oliwer11/growatt-heater-en-rs485/docs/Relay_5V_2-channel.png

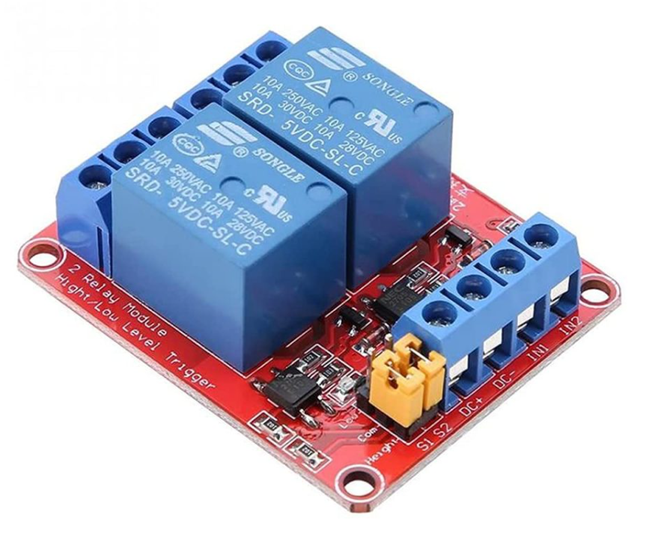
docs/Relay_5V_2-channel.png
