oliwer11/growatt-heater-en-rs485/docs/UART_TTL_RS485_MAX485_5V_ARDUINO.png

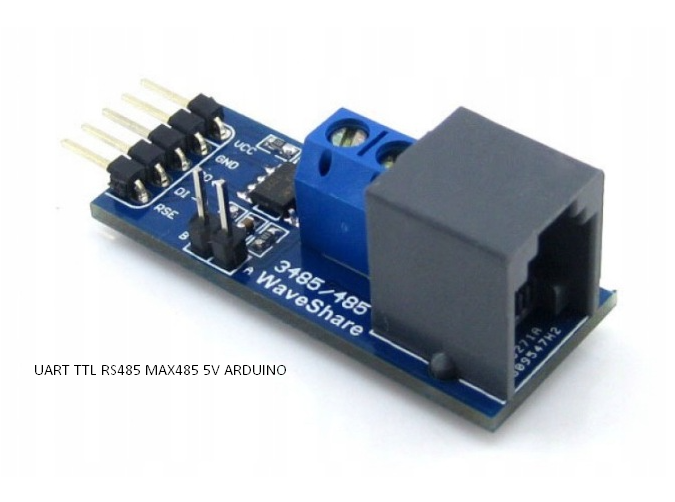
docs/UART_TTL_RS485_MAX485_5V_ARDUINO.png
