oliwer11/growatt-heater-en-rs485/docs/RS485_top_view.png

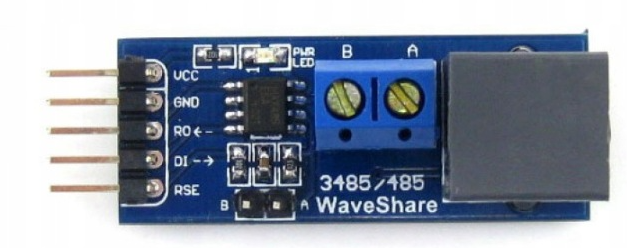
docs/RS485_top_view.png
