oliwer11/growatt-heater-en-rs485/docs/Growatt-heater-wiring-diagram.pdf

/ -L1_1

/ -N_1

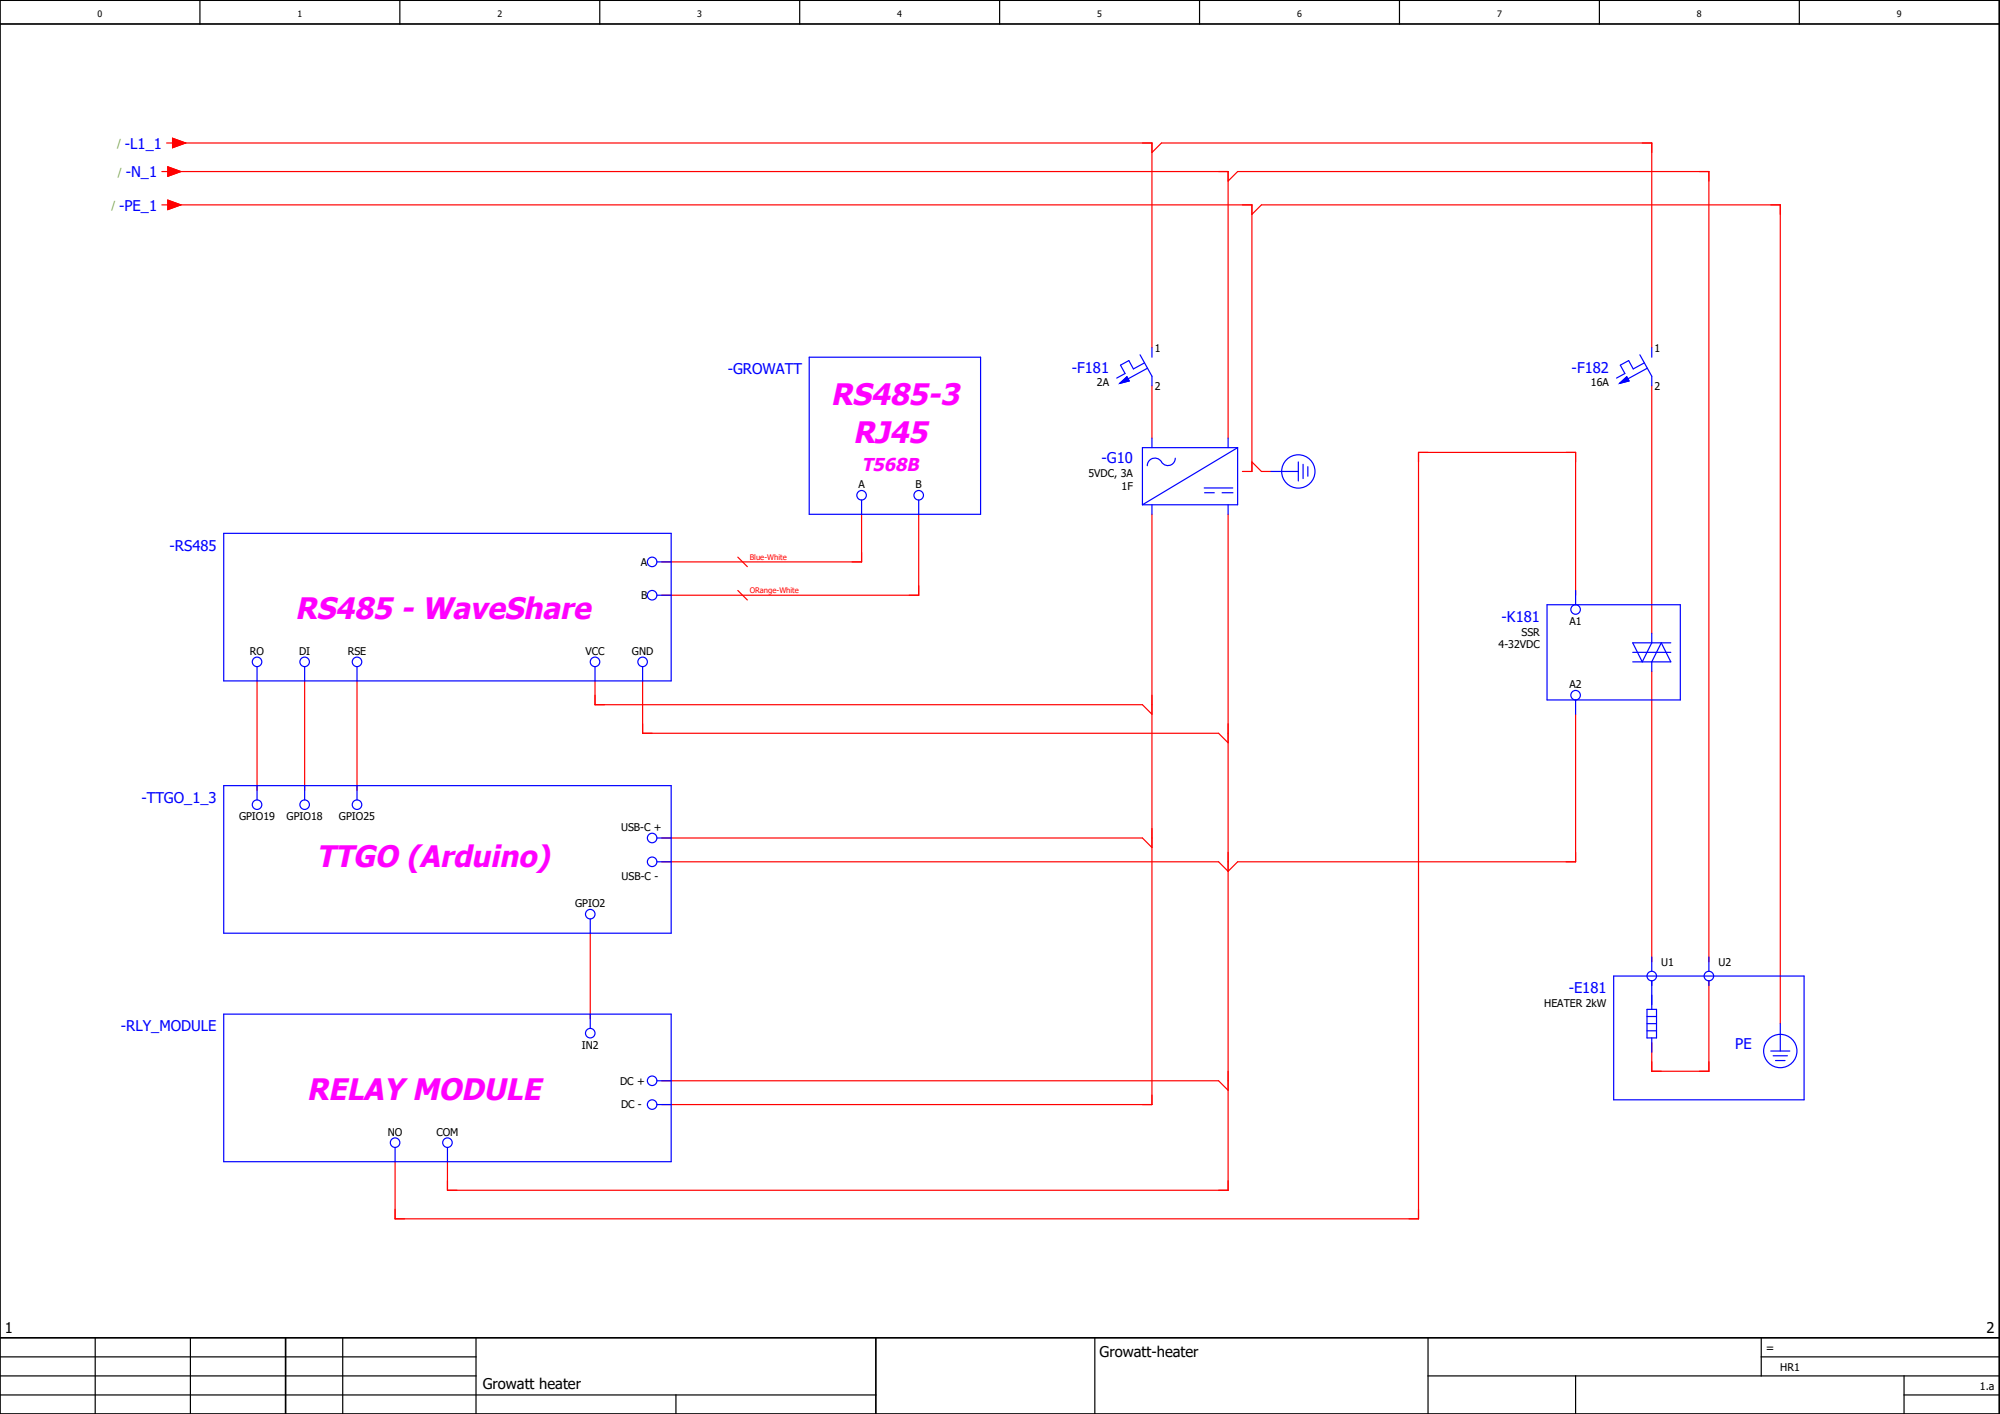
[picture p5: page 1]
Growatt heater; Growatt-heater; RS485 - WaveShare; TTGO (Arduino); RELAY MODULE; -TTGO_1_3; -RLY_MODULE; RSE; VCC; GND; -GROWATT; Blue-White; ORange-White; USB-C +; USB-C -; 5VDC, 3A 1F; SSR 4-32VDC; HEATER 2kW; COM; GPIO19 GPIO18; GPIO25; GPIO2
