oliwer11/growatt-heater-en-rs485/(commit log)

2026-08-27 Growatt SPH heater controller for ESP32
    Reads a Growatt SPH 10000TL3 BH-UP over Modbus RTU / RS485, serves a
    dashboard from its own WiFi AP, and switches an SSR to dump surplus
    solar into a water heater.
    Includes the two findings that make it work at all: the ESP32
    Serial.flush() returning before the last bits leave the UART (which
    truncates the frame if DE drops immediately), and the transceiver
    echoing back our own transmission (which byte-oriented Modbus
    libraries misread as a foreign address).
2026-08-27 Rename sketch to growatt-heater-en-rs485.ino
    The Arduino IDE requires the .ino basename to match its containing
    folder, so the repository, the folder and the sketch all carry the
    same name.
2026-08-27 README: call out the RS485-3 socket on the front page
    Which socket the cable goes into is the difference between working and
    silent, so it belongs above the fold rather than only in the port
    section further down.
2026-08-27 Document the actual build: plain relay module, and add docs/
    The heater ended up being switched by an ordinary relay module rather
    than the SSR and optocoupler the project started with. The coil runs on
    5 V from a separate supply and the module's IN pin is driven straight
    from the ESP32's 3.3 V GPIO, so no series resistor is involved.
    Flags the active-LOW relay board hazard: the firmware drives the pin LOW
    first thing in setup() as its safe state, which inverts into "heater on
    at every boot" on an active-LOW module.
    Firmware identifiers still read SSR_*; only the hardware description
    changed.
    Adds docs/ for the schematic, build photo and inverter manual.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
    [growatt-heater-en-rs485.ino]
2026-08-27 docs: index the uploaded material, confirm the relay is active-HIGH
    Names every file in docs/ and adds the Waveshare header labels, whose
    direction pin is silkscreened RSE rather than DE/RE.
    The relay module on this build is active-HIGH, which is what the
    firmware already assumes, so no logic change. The active-LOW hazard note
    stays for anyone copying the project.
2026-08-27 README: explain the problem the project solves
    A hybrid inverter with a battery charges it first and, under a virtual
    battery arrangement, exports nothing — so the export register a surplus
    controller would normally watch reads zero all day. This documents why
    the controller infers surplus from string voltage and state of charge
    instead.
2026-08-27 Correct the output stage: the relay drives the SSR, it does not replace it
    An earlier commit wrongly recorded the SSR as dropped from the design.
    The schematic has the ESP32 driving a relay module on IN2, whose contact
    closes the SSR control input (A1/A2, 4-32 V DC), with the SSR carrying
    the 2 kW heater current.
    That also retires the contact-wear warning from the previous version:
    the relay contact only ever passes the SSR's control current.
    Component designators, fuse ratings and the heater rating now match the
    schematic in docs/.
    [growatt-heater-en-rs485.ino]
